NotARoomba/Athena/hardware/athena.kicad_pcb

## KiCad design hardware/athena.kicad_pcb (2026-08-28)

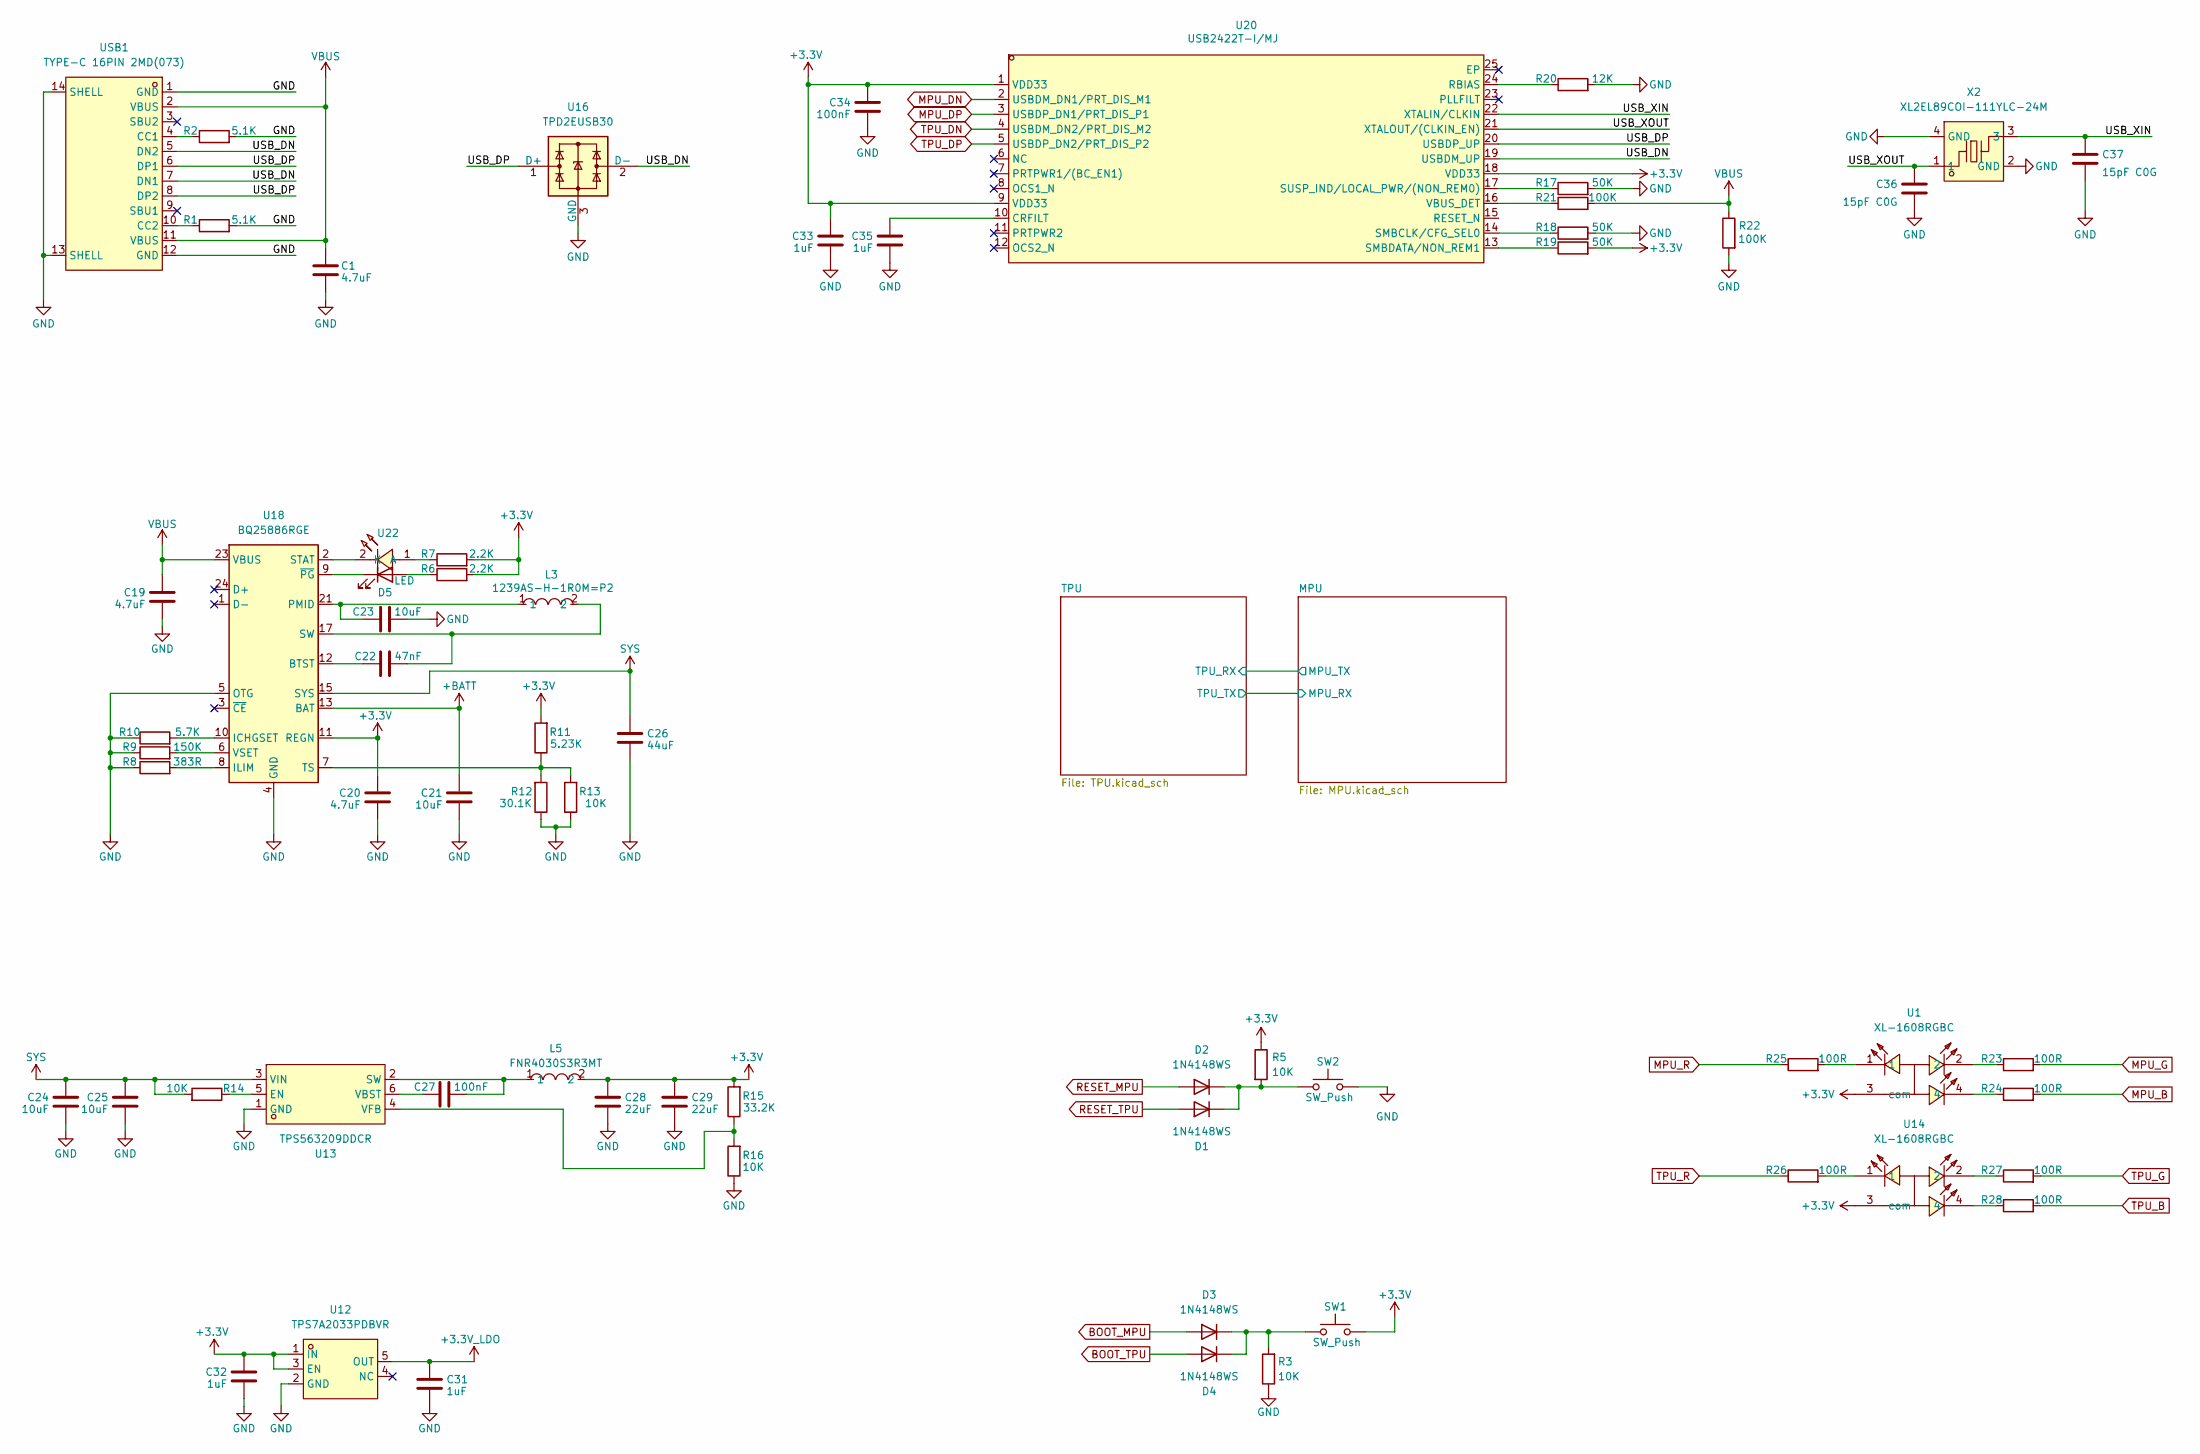
[picture p1: schematic athena.kicad_sch]

Parts:
C1, C19, C20: 4.7uF; C_0603_1608Metric
C21, C23, C24, C25: 10uF; C_0603_1608Metric
C22: 47nF; C_0402_1005Metric
C26: 44uF; C_0805_2012Metric
C27: 100nF; C_0402_1005Metric
C28, C29: 22uF; C_0805_2012Metric
C31, C32, C33, C35: 1uF; C_0402_1005Metric_Pad0.74x0.62mm_HandSolder
C34: 100nF; C_0402_1005Metric_Pad0.74x0.62mm_HandSolder
C36, C37: 15pF C0G; C_0402_1005Metric_Pad0.74x0.62mm_HandSolder
D1, D2, D3, D4: 1N4148WS; D_SOD-323
D5: LED; LED_0402_1005Metric; LCSC C52125197
L3: 1239AS-H-1R0M=P2; L1008; MPN 1239AS-H-1R0M=P2; LCSC Part C167447
L5: FNR4030S3R3MT; IND-SMD_L4.0-W4.0_FNR40XXS; MPN FNR4030S3R3MT; LCSC Part C167870
R1, R2: 5.1K; R_0402_1005Metric
R3, R5, R13, R14, R16: 10K; R_0402_1005Metric
R6, R7: 2.2K; R_0402_1005Metric
R8: 383R; R_0402_1005Metric
R9: 150K; R_0402_1005Metric
R10: 5.7K; R_0402_1005Metric
R11: 5.23K; R_0402_1005Metric
R12: 30.1K; R_0402_1005Metric
R15: 33.2K; R_0402_1005Metric
R17, R18, R19: 50K; R_0402_1005Metric
R20: 12K; R_0402_1005Metric
R21, R22: 100K; R_0402_1005Metric
R23, R24, R25, R26, R27, R28: 100R; R_0402_1005Metric
SW1, SW2: SW_Push; SW-SMD_L3.9-W3.0-P4.45; LCSC C720477
U1, U14: XL-1608RGBC; LED-SMD_4P-L1.6-W0.8-BL; MPN XL-1608RGBC; LCSC Part C5349936
U12: TPS7A2033PDBVR; SOT-23-5_L2.9-W1.6-P0.95-LS2.8-BR; LCSC Part C2862740
U13: TPS563209DDCR; SOT-23-6_L2.9-W1.6-P0.95-LS2.8-BR; LCSC Part C181974
U16: TPD2EUSB30; Texas_DRT-3
U18: BQ25886RGE; Texas_RGE0024H_VQFN-24-1EP_4x4mm_P0.5mm_EP2.7x2.7mm
U20: USB2422T-I/MJ; QFN-24_L4.0-W4.0-P0.50-TL-EP2.5; LCSC Part C622610
U22: SZYY0402Y_C434450; LED0402-FD_YELLOW; LCSC Part C434450
USB1: TYPE-C 16PIN 2MD(073); USB-C-SMD_TYPE-C-6PIN-2MD-073; LCSC Part C2765186
X2: XL2EL89COI-111YLC-24M; CRYSTAL-SMD_4P-L3.2-W2.5-BL; MPN XL2EL89COI-111YLC-24M; LCSC Part C5444545

Connections:
+3.3V: C20.1, C28.1, C29.1, C32.1, C33.1, C34.1, L5.2, R5.1, R6.2, R7.2, R11.2, R15.2, R19.2, SW1.2, U1.3 (com), U12.1 (IN), U12.3 (EN), U14.3 (com), U18.11 (REGN), U20.1 (VDD33), U20.9 (VDD33), U20.18 (VDD33); also elsewhere on the board
+3.3V_LDO: C31.1, U12.5 (OUT); also elsewhere on the board
+BATT: C21.1, U18.13 (BAT), U18.14 (BAT)
/USB_DN: U16.2 (D-), U20.19 (USBDM_UP), USB1.5 (DN2), USB1.7 (DN1)
/USB_DP: U16.1 (D+), U20.20 (USBDP_UP), USB1.6 (DP1), USB1.8 (DP2)
/USB_XIN: C37.1, U20.22 (XTALIN/CLKIN), X2.3
/USB_XOUT: C36.1, U20.21 (XTALOUT/(CLKIN_EN)), X2.1
BOOT_MPU: D3.2 (A); also elsewhere on the board
BOOT_TPU: D4.2 (A); also elsewhere on the board
GND: C1.2, C19.2, C20.2, C21.2, C23.2, C24.2, C25.2, C26.2, C28.2, C29.2, C31.2, C32.2, C33.2, C34.2, C35.2, C36.2, C37.2, R1.2, R2.2, R3.1, R8.1, R9.1, R10.1, R12.1, R13.1, R16.1, R17.2, R18.2, R20.2, R22.2, SW2.2, U12.2 (GND), U13.1 (GND), U16.3 (GND), U18.4 (GND), U18.5 (OTG), U18.19 (GND), U18.20 (GND), U18.25 (GND), USB1.1 (GND), USB1.12 (GND), USB1.13 (SHELL), USB1.14 (SHELL), X2.2 (GND), X2.4 (GND); also elsewhere on the board
MPU_B: R24.2; also elsewhere on the board
MPU_DN: U20.2 (USBDM_DN1/PRT_DIS_M1); also elsewhere on the board
MPU_DP: U20.3 (USBDP_DN1/PRT_DIS_P1); also elsewhere on the board
MPU_G: R23.2; also elsewhere on the board
MPU_R: R25.1; also elsewhere on the board
unnamed: C22.1, L3.2, U18.17 (SW), U18.18 (SW)
unnamed: C23.1, L3.1, U18.21 (PMID), U18.22 (PMID)
unnamed: D1.1 (K), D2.1 (K), R5.2, SW2.1
unnamed: D3.1 (K), D4.1 (K), R3.2, SW1.1
unnamed: D5.2 (A), R6.1
unnamed: D5.1 (K), U18.9 (~PG)
unnamed: R23.1, U1.2
unnamed: R24.1, U1.4
unnamed: R25.2, U1.1
unnamed: R26.2, U14.1
unnamed: R27.1, U14.2
unnamed: R28.1, U14.4
unnamed: R14.1, U13.5 (EN)
unnamed: C27.1, L5.1, U13.2 (SW)
unnamed: C27.2, U13.6 (VBST)
unnamed: R15.1, R16.2, U13.4 (VFB)
unnamed: C22.2, U18.12 (BTST)
unnamed: R10.2, U18.10 (ICHGSET)
unnamed: R8.2, U18.8 (ILIM)
unnamed: U18.2 (STAT), U22.2 (K)
unnamed: R11.1, R12.2, R13.2, U18.7 (TS)
unnamed: R9.2, U18.6 (VSET)
unnamed: C35.1, U20.10 (CRFILT)
unnamed: R20.1, U20.24 (RBIAS)
unnamed: R18.1, U20.14 (SMBCLK/CFG_SEL0)
unnamed: R19.1, U20.13 (SMBDATA/NON_REM1)
unnamed: R17.1, U20.17 (SUSP_IND/LOCAL_PWR/(NON_REM0))
unnamed: R21.1, U20.16 (VBUS_DET)
unnamed: R7.1, U22.1 (A)
unnamed: R2.1, USB1.4 (CC1)
unnamed: R1.1, USB1.10 (CC2)
RESET_MPU: D2.2 (A); also elsewhere on the board
RESET_TPU: D1.2 (A); also elsewhere on the board
SYS: C24.1, C25.1, C26.1, R14.2, U13.3 (VIN), U18.15 (SYS), U18.16 (SYS)
TPU_B: R28.2; also elsewhere on the board
TPU_DN: U20.4 (USBDM_DN2/PRT_DIS_M2); also elsewhere on the board
TPU_DP: U20.5 (USBDP_DN2/PRT_DIS_P2); also elsewhere on the board
TPU_G: R27.2; also elsewhere on the board
TPU_R: R26.1; also elsewhere on the board
VBUS: C1.1, C19.1, R21.2, R22.1, U18.23 (VBUS), USB1.2 (VBUS), USB1.11 (VBUS)

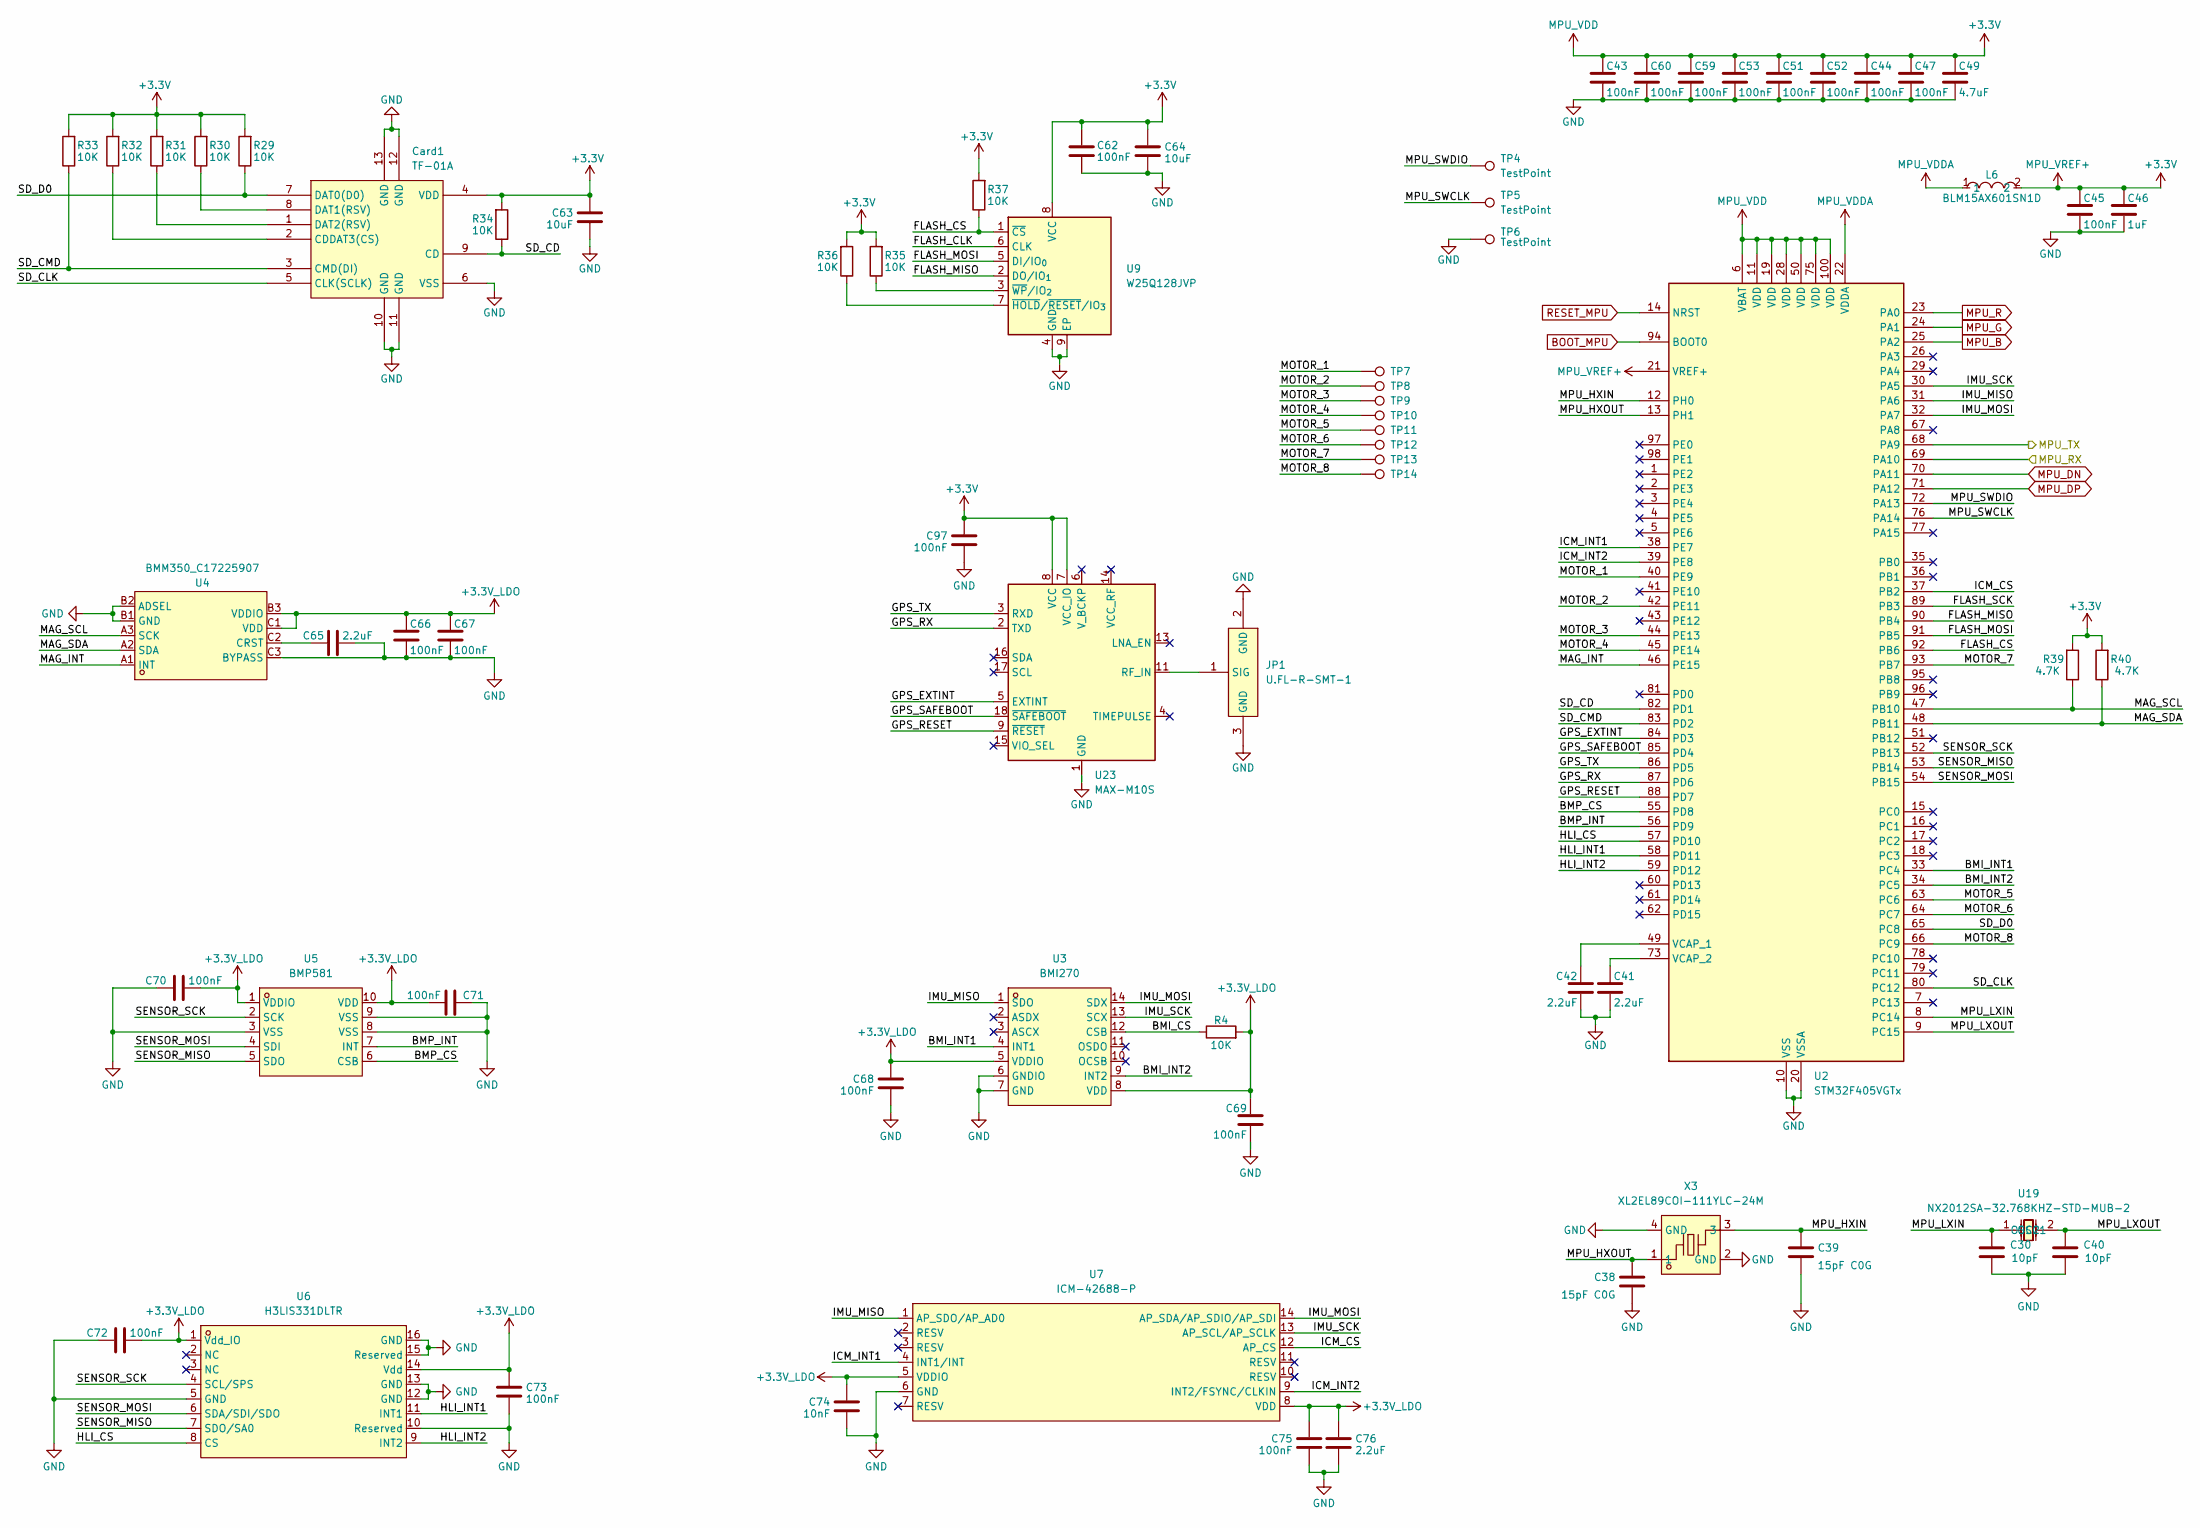
[picture p2: schematic MPU.kicad_sch]

Parts:
C30, C40: 10pF; C_0402_1005Metric
C38, C39: 15pF C0G; C_0402_1005Metric_Pad0.74x0.62mm_HandSolder
C41, C42, C65, C76: 2.2uF; C_0402_1005Metric
C43, C44, C45, C47, C51, C52, C53, C59, C60, C62, C66, C67, C68, C69, C70, C71, C72, C73, C75, C97: 100nF; C_0402_1005Metric
C46: 1uF; C_0402_1005Metric
C49: 4.7uF; C_0603_1608Metric
C63, C64: 10uF; C_0603_1608Metric
C74: 10nF; C_0402_1005Metric
Card1: TF-01A; TF-SMD_TF-01A; LCSC Part C91145
JP1: U.FL-R-SMT-1; RF-SMD_FRF05002-JSS103M; MPN U.FL-R-SMT-1(80); LCSC Part C88374
L6: BLM15AX601SN1D; L0402; MPN BLM15AX601SN1D; LCSC Part C76886
R4, R29, R30, R31, R32, R33, R34, R35, R36, R37: 10K; R_0402_1005Metric
R39, R40: 4.7K; R_0402_1005Metric
TP4, TP5, TP6: TestPoint; TestPoint_Pad_1.0x1.0mm
TP7, TP8, TP9, TP10, TP11, TP12, TP13, TP14: TestPoint; TestPoint_Pill
U2: STM32F405VGTx; LQFP-100_14x14mm_P0.5mm
U3: BMI270; LGA-14_L3.0-W2.5-P0.50-BR; LCSC Part C2836813
U4: BMM350_C17225907; WLCSP-9_L1.3-W1.3-R3-C3-P0.40-TL; LCSC Part C17225907
U5: BMP581; LGA-10_L2.0-W2.0-P0.50-TL_BMP581; LCSC Part C5362283
U6: H3LIS331DLTR; LGA-16_L3.0-W3.0-P0.50-BL; LCSC Part C2655074
U7: ICM-42688-P; LGA-14_L3.0-W2.5-P0.50-TL; LCSC Part C1850418
U9: W25Q128JVP; WSON-8-1EP_6x5mm_P1.27mm_EP3.4x4.3mm
U19: NX2012SA-32.768KHZ-STD-MUB-2; CRYSTAL-SMD_L2.0-W1.2; LCSC Part C891748
U23: MAX-M10S; ublox_MAX
X3: XL2EL89COI-111YLC-24M; CRYSTAL-SMD_4P-L3.2-W2.5-BL; MPN XL2EL89COI-111YLC-24M; LCSC Part C5444545

Connections:
+3.3V: C43.1, C44.1, C45.1, C46.1, C47.1, C49.1, C51.1, C52.1, C53.1, C59.1, C60.1, C62.1, C63.1, C64.1, C97.1, Card1.4 (VDD), L6.2, R29.2, R30.2, R31.2, R32.2, R33.2, R34.2, R35.2, R36.2, R37.2, R39.2, R40.2, U2.6 (VBAT), U2.11 (VDD), U2.19 (VDD), U2.21 (VREF+), U2.28 (VDD), U2.50 (VDD), U2.75 (VDD), U2.100 (VDD), U9.8 (VCC), U23.7 (VCC_IO), U23.8 (VCC); also elsewhere on the board
+3.3V_LDO: C66.1, C67.1, C68.1, C69.1, C70.2, C71.2, C72.2, C73.1, C74.1, C75.1, C76.1, R4.2, U3.5 (VDDIO), U3.8 (VDD), U4.B3 (VDDIO), U4.C1 (VDD), U5.1 (VDDIO), U5.10 (VDD), U6.1 (Vdd_IO), U6.14 (Vdd), U7.5 (VDDIO), U7.8 (VDD); also elsewhere on the board
/MPU/BMI_CS: R4.1, U3.12 (CSB)
/MPU/BMI_INT1: U2.33 (PC4), U3.4 (INT1)
/MPU/BMI_INT2: U2.34 (PC5), U3.9 (INT2)
/MPU/BMP_CS: U2.55 (PD8), U5.6 (CSB)
/MPU/BMP_INT: U2.56 (PD9), U5.7 (INT)
/MPU/FLASH_CLK: U9.6 (CLK)
/MPU/FLASH_CS: R37.1, U2.92 (PB6), U9.1 (~CS)
/MPU/FLASH_MISO: U2.90 (PB4), U9.2 (DO/IO_{1})
/MPU/FLASH_MOSI: U2.91 (PB5), U9.5 (DI/IO_{0})
/MPU/FLASH_SCK: U2.89 (PB3)
/MPU/GPS_EXTINT: U2.84 (PD3), U23.5 (EXTINT)
/MPU/GPS_RESET: U2.88 (PD7), U23.9 (~RESET)
/MPU/GPS_RX: U2.87 (PD6), U23.2 (TXD)
/MPU/GPS_SAFEBOOT: U2.85 (PD4), U23.18 (~SAFEBOOT)
/MPU/GPS_TX: U2.86 (PD5), U23.3 (RXD)
/MPU/HLI_CS: U2.57 (PD10), U6.8 (CS)
/MPU/HLI_INT1: U2.58 (PD11), U6.11 (INT1)
/MPU/HLI_INT2: U2.59 (PD12), U6.9 (INT2)
/MPU/ICM_CS: U2.37 (PB2), U7.12 (AP_CS)
/MPU/ICM_INT1: U2.38 (PE7), U7.4 (INT1/INT)
/MPU/ICM_INT2: U2.39 (PE8), U7.9 (INT2/FSYNC/CLKIN)
/MPU/IMU_MISO: U2.31 (PA6), U3.1 (SDO), U7.1 (AP_SDO/AP_AD0)
/MPU/IMU_MOSI: U2.32 (PA7), U3.14 (SDX), U7.14 (AP_SDA/AP_SDIO/AP_SDI)
/MPU/IMU_SCK: U2.30 (PA5), U3.13 (SCX), U7.13 (AP_SCL/AP_SCLK)
/MPU/MAG_INT: U2.46 (PE15), U4.A1 (INT)
/MPU/MAG_SCL: R39.1, U2.47 (PB10), U4.A3 (SCK)
/MPU/MAG_SDA: R40.1, U2.48 (PB11), U4.A2 (SDA)
/MPU/MOTOR_1: TP7.1 (1_1), U2.40 (PE9)
/MPU/MOTOR_2: TP8.1 (1_1), U2.42 (PE11)
/MPU/MOTOR_3: TP9.1 (1_1), U2.44 (PE13)
/MPU/MOTOR_4: TP10.1 (1_1), U2.45 (PE14)
/MPU/MOTOR_5: TP11.1 (1_1), U2.63 (PC6)
/MPU/MOTOR_6: TP12.1 (1_1), U2.64 (PC7)
/MPU/MOTOR_7: TP13.1 (1_1), U2.93 (PB7)
/MPU/MOTOR_8: TP14.1 (1_1), U2.66 (PC9)
/MPU/MPU_HXIN: C39.1, U2.12 (PH0), X3.3
/MPU/MPU_HXOUT: C38.1, U2.13 (PH1), X3.1
/MPU/MPU_LXIN: C30.1, U2.8 (PC14), U19.1 (OSC1)
/MPU/MPU_LXOUT: C40.1, U2.9 (PC15), U19.2 (OSC2)
/MPU/MPU_RX: U2.69 (PA10); also elsewhere on the board
/MPU/MPU_SWCLK: TP5.1 (1_1), U2.76 (PA14)
/MPU/MPU_SWDIO: TP4.1 (1_1), U2.72 (PA13)
/MPU/MPU_TX: U2.68 (PA9); also elsewhere on the board
/MPU/SD_CD: Card1.9 (CD), R34.1, U2.82 (PD1)
/MPU/SD_CLK: Card1.5 (CLK(SCLK)), U2.80 (PC12)
/MPU/SD_CMD: Card1.3 (CMD(DI)), R33.1, U2.83 (PD2)
/MPU/SD_D0: Card1.7 (DAT0(D0)), R29.1, U2.65 (PC8)
/MPU/SENSOR_MISO: U2.53 (PB14), U5.5 (SDO), U6.7 (SDO/SA0)
/MPU/SENSOR_MOSI: U2.54 (PB15), U5.4 (SDI), U6.6 (SDA/SDI/SDO)
/MPU/SENSOR_SCK: U2.52 (PB13), U5.2 (SCK), U6.4 (SCL/SPS)
BOOT_MPU: U2.94 (BOOT0); also elsewhere on the board
GND: C30.2, C38.2, C39.2, C40.2, C41.2, C42.2, C43.2, C44.2, C45.2, C46.2, C47.2, C49.2, C51.2, C52.2, C53.2, C59.2, C60.2, C62.2, C63.2, C64.2, C65.1, C66.2, C67.2, C68.2, C69.2, C70.1, C71.1, C72.1, C73.2, C74.2, C75.2, C76.2, C97.2, Card1.6 (VSS), Card1.10 (GND), Card1.11 (GND), Card1.12 (GND), Card1.13 (GND), JP1.2 (GND), JP1.3 (GND), TP6.1 (1_1), U2.10 (VSS), U2.20 (VSSA), U2.27 (VSS), U2.74 (VSS), U2.99 (VSS), U3.6 (GNDIO), U3.7 (GND), U4.B1 (GND), U4.B2 (ADSEL), U4.C3 (BYPASS), U5.3 (VSS), U5.8 (VSS), U5.9 (VSS), U6.5 (GND), U6.10 (Reserved), U6.12 (GND), U6.13 (GND), U6.15 (Reserved), U6.16 (GND), U7.6 (GND), U9.4 (GND), U9.9 (EP), U23.1 (GND), U23.10 (GND), U23.12 (GND), X3.2 (GND), X3.4 (GND); also elsewhere on the board
MPU_B: U2.25 (PA2); also elsewhere on the board
MPU_DN: U2.70 (PA11); also elsewhere on the board
MPU_DP: U2.71 (PA12); also elsewhere on the board
MPU_G: U2.24 (PA1); also elsewhere on the board
MPU_R: U2.23 (PA0); also elsewhere on the board
MPU_VDDA: L6.1, U2.22 (VDDA)
unnamed: Card1.2 (CDDAT3(CS)), R32.1
unnamed: Card1.8 (DAT1(RSV)), R30.1
unnamed: Card1.1 (DAT2(RSV)), R31.1
unnamed: JP1.1 (SIG), U23.11 (RF_IN)
unnamed: C42.1, U2.49 (VCAP_1)
unnamed: C41.1, U2.73 (VCAP_2)
unnamed: C65.2, U4.C2 (CRST)
unnamed: R36.1, U9.7 (~HOLD/~RESET/IO_{3})
unnamed: R35.1, U9.3 (~WP/IO_{2})
RESET_MPU: U2.14 (NRST); also elsewhere on the board

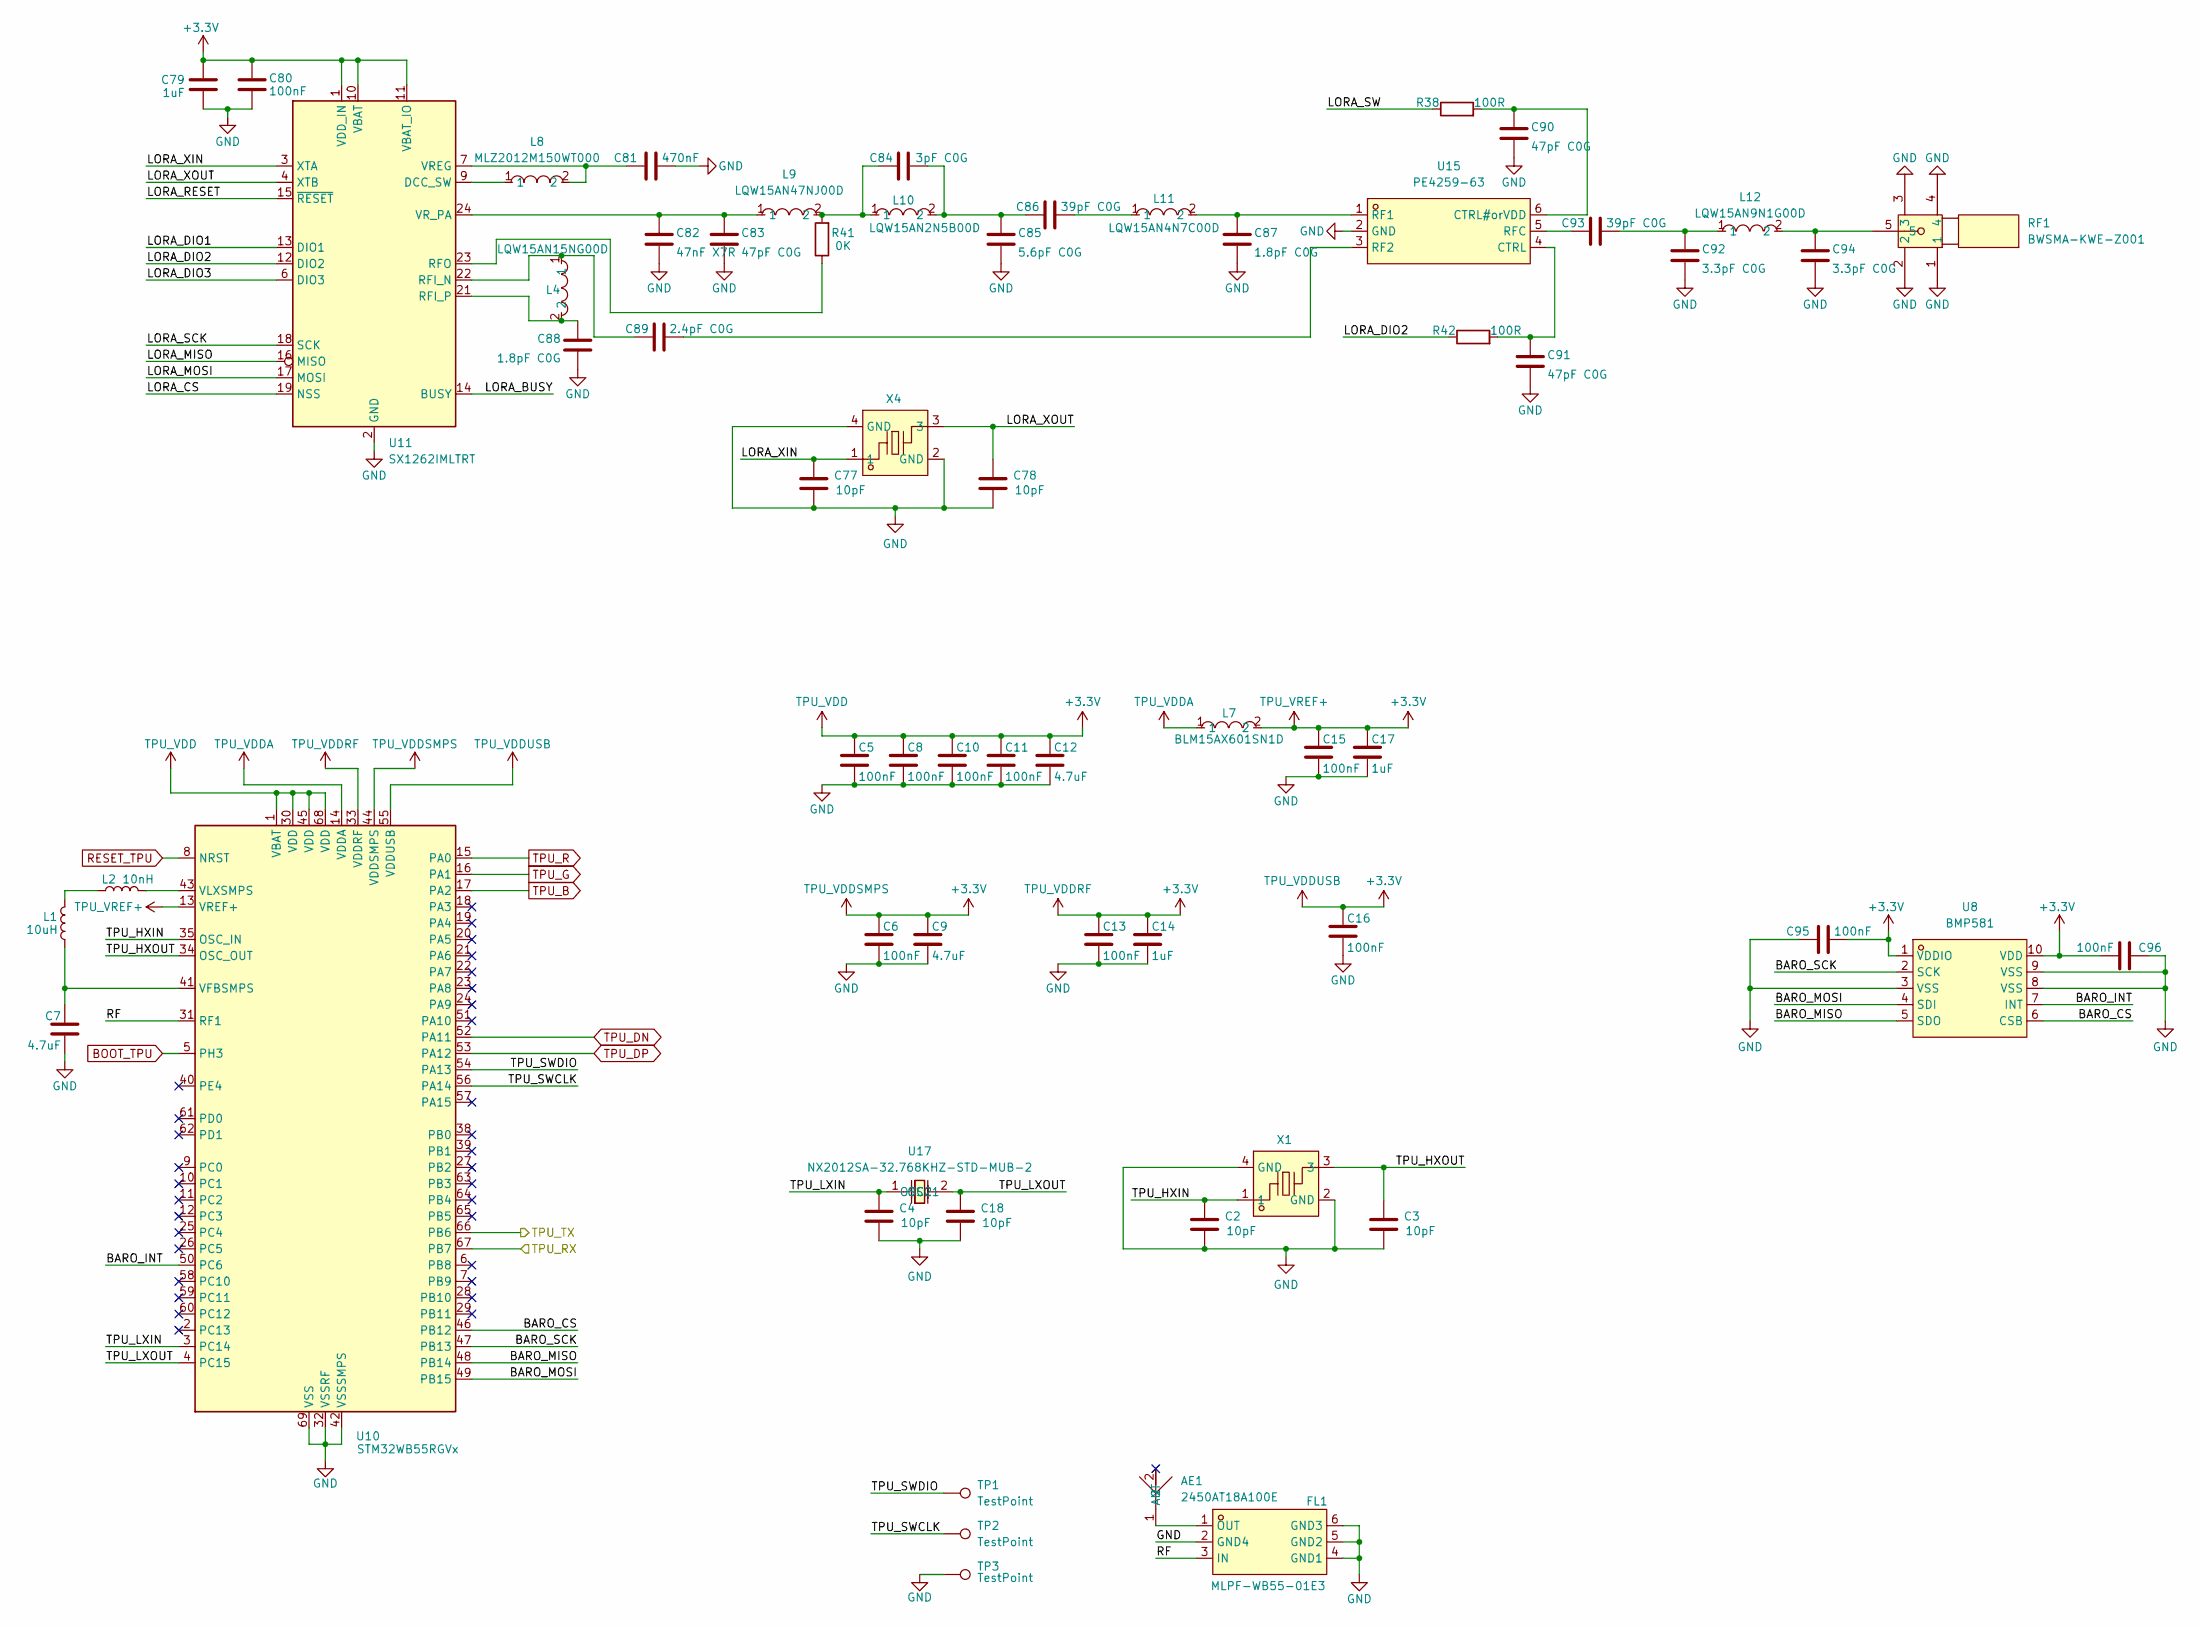
[picture p3: schematic TPU.kicad_sch]

Parts:
AE1: 2450AT18A100E; ANT-SMD_L3.2-W1.6; LCSC Part C89334
C2, C3, C4, C18, C77, C78: 10pF; C_0402_1005Metric
C5, C6, C8, C10, C11, C13, C15, C16, C80, C95, C96: 100nF; C_0402_1005Metric
C7, C9, C12: 4.7uF; C_0603_1608Metric
C14, C17: 1uF; C_0402_1005Metric
C79: 1uF; C_0402_1005Metric_Pad0.74x0.62mm_HandSolder
C81: 470nF; C_0402_1005Metric
C82: 47nF X7R; C_0402_1005Metric
C83, C90, C91: 47pF C0G; C_0402_1005Metric
C84: 3pF C0G; C_0402_1005Metric
C85: 5.6pF C0G; C_0402_1005Metric
C86, C93: 39pF C0G; C_0402_1005Metric
C87, C88: 1.8pF C0G; C_0402_1005Metric
C89: 2.4pF C0G; C_0402_1005Metric
C92, C94: 3.3pF C0G; C_0402_1005Metric
FL1: MLPF-WB55-01E3; FILTER-SMD_6P-L1.6-W1.0-P0.50-BL; LCSC Part C2651048
L1: 10uH; L_0603_1608Metric
L2: 10nH; L_0603_1608Metric
L4: LQW15AN15NG00D; IND-SMD_L1.0-W0.5-2; MPN LQW15AN15NG00D; LCSC Part C98055
L7: BLM15AX601SN1D; L0402; MPN BLM15AX601SN1D; LCSC Part C76886
L8: MLZ2012M150WT000; L0805; MPN MLZ2012M150WT000; LCSC Part C383402
L9: LQW15AN47NJ00D; L0402; MPN LQW15AN47NJ00D; LCSC Part C192855
L10: LQW15AN2N5B00D; L0402; MPN LQW15AN2N5B00D; LCSC Part C237342
L11: LQW15AN4N7C00D; L0402; MPN LQW15AN4N7C00D; LCSC Part C167480
L12: LQW15AN9N1G00D; L0402; MPN LQW15AN9N1G00D; LCSC Part C113122
R38, R42: 100R; R_0402_1005Metric
R41: 0K; R_0402_1005Metric
RF1: BWSMA-KWE-Z001; SMA-TH_BWSMA-KWE-Z001; LCSC Part C496551
TP1, TP2, TP3: TestPoint; TestPoint_Pad_1.0x1.0mm
U8: BMP581; LGA-10_L2.0-W2.0-P0.50-TL_BMP581; LCSC Part C5362283
U10: STM32WB55RGVx; QFN-68-1EP_8x8mm_P0.4mm_EP6.4x6.4mm; LCSC C401505
U11: SX1262IMLTRT; QFN-24-1EP_4x4mm_P0.5mm_EP2.6x2.6mm
U15: PE4259-63; SC-70-6_L2.2-W1.3-P0.65-LS2.1-BL; MPN PE4259-63; LCSC Part C470892
U17: NX2012SA-32.768KHZ-STD-MUB-2; CRYSTAL-SMD_L2.0-W1.2; LCSC Part C891748
X1, X4: NX2016SA-32MHZ-STD-CZS-5; OSC-SMD_4P-L2.0-W1.6-BL; LCSC Part C843260

Connections:
+3.3V: C5.1, C6.1, C8.1, C9.1, C10.1, C11.1, C12.1, C13.1, C14.1, C15.1, C16.1, C17.1, C79.1, C80.1, C95.2, C96.2, L7.2, U8.1 (VDDIO), U8.10 (VDD), U10.1 (VBAT), U10.13 (VREF+), U10.30 (VDD), U10.33 (VDDRF), U10.44 (VDDSMPS), U10.45 (VDD), U10.55 (VDDUSB), U10.68 (VDD), U11.1 (VDD_IN), U11.10 (VBAT), U11.11 (VBAT_IO); also elsewhere on the board
/MPU/MPU_RX: U10.66 (PB6); also elsewhere on the board
/MPU/MPU_TX: U10.67 (PB7); also elsewhere on the board
/TPU/BARO_CS: U8.6 (CSB), U10.46 (PB12)
/TPU/BARO_INT: U8.7 (INT), U10.50 (PC6)
/TPU/BARO_MISO: U8.5 (SDO), U10.48 (PB14)
/TPU/BARO_MOSI: U8.4 (SDI), U10.49 (PB15)
/TPU/BARO_SCK: U8.2 (SCK), U10.47 (PB13)
/TPU/LORA_BUSY: U11.14 (BUSY)
/TPU/LORA_CS: U11.19 (NSS)
/TPU/LORA_DIO1: U11.13 (DIO1)
/TPU/LORA_DIO2: R42.1, U11.12 (DIO2)
/TPU/LORA_DIO3: U11.6 (DIO3)
/TPU/LORA_MISO: U11.16 (MISO)
/TPU/LORA_MOSI: U11.17 (MOSI)
/TPU/LORA_RESET: U11.15 (~RESET)
/TPU/LORA_SCK: U11.18 (SCK)
/TPU/LORA_SW: R38.1
/TPU/LORA_XIN: C77.1, U11.3 (XTA), X4.1
/TPU/LORA_XOUT: C78.1, U11.4 (XTB), X4.3
/TPU/RF: FL1.3 (IN), U10.31 (RF1)
/TPU/TPU_HXIN: C2.1, U10.35 (OSC_IN), X1.1
/TPU/TPU_HXOUT: C3.1, U10.34 (OSC_OUT), X1.3
/TPU/TPU_LXIN: C4.1, U10.3 (PC14), U17.1 (OSC1)
/TPU/TPU_LXOUT: C18.1, U10.4 (PC15), U17.2 (OSC2)
/TPU/TPU_SWCLK: TP2.1 (1_1), U10.56 (PA14)
/TPU/TPU_SWDIO: TP1.1 (1_1), U10.54 (PA13)
BOOT_TPU: U10.5 (PH3); also elsewhere on the board
GND: C2.2, C3.2, C4.2, C5.2, C6.2, C7.2, C8.2, C9.2, C10.2, C11.2, C12.2, C13.2, C14.2, C15.2, C16.2, C17.2, C18.2, C77.2, C78.2, C79.2, C80.2, C81.2, C82.2, C83.2, C85.2, C87.2, C88.2, C90.2, C91.2, C92.2, C94.2, C95.1, C96.1, FL1.2 (GND4), FL1.4 (GND1), FL1.5 (GND2), FL1.6 (GND3), RF1.1, RF1.2, RF1.3, RF1.4, TP3.1 (1_1), U8.3 (VSS), U8.8 (VSS), U8.9 (VSS), U10.32 (VSSRF), U10.42 (VSSSMPS), U10.69 (VSS), U11.2 (GND), U11.5 (GND), U11.8 (GND), U11.20 (GND), U11.25 (GND), U15.2 (GND), X1.2 (GND), X1.4 (GND), X4.2 (GND), X4.4 (GND); also elsewhere on the board
unnamed: AE1.1 (ANT_1), FL1.1 (OUT)
unnamed: C84.1, L9.2, L10.1, R41.2
unnamed: C84.2, C85.1, C86.1, L10.2
unnamed: C86.2, L11.1
unnamed: C92.1, C93.2, L12.1
unnamed: C94.1, L12.2, RF1.5
unnamed: L1.1, L2.2
unnamed: C7.1, L1.2, U10.41 (VFBSMPS)
unnamed: L2.1, U10.43 (VLXSMPS)
unnamed: L8.1, U11.9 (DCC_SW)
unnamed: C89.1, L4.1, U11.22 (RFI_N)
unnamed: C88.1, L4.2, U11.21 (RFI_P)
unnamed: R41.1, U11.23 (RFO)
unnamed: C81.1, L8.2, U11.7 (VREG)
unnamed: C82.1, C83.1, L9.1, U11.24 (VR_PA)
unnamed: C90.1, R38.2, U15.6 (CTRL#orVDD)
unnamed: C91.1, R42.2, U15.4 (CTRL)
unnamed: C87.1, L11.2, U15.1 (RF1)
unnamed: C89.2, U15.3 (RF2)
unnamed: C93.1, U15.5 (RFC)
RESET_TPU: U10.8 (NRST); also elsewhere on the board
TPU_B: U10.17 (PA2); also elsewhere on the board
TPU_DN: U10.52 (PA11); also elsewhere on the board
TPU_DP: U10.53 (PA12); also elsewhere on the board
TPU_G: U10.16 (PA1); also elsewhere on the board
TPU_R: U10.15 (PA0); also elsewhere on the board
TPU_VDDA: L7.1, U10.14 (VDDA)

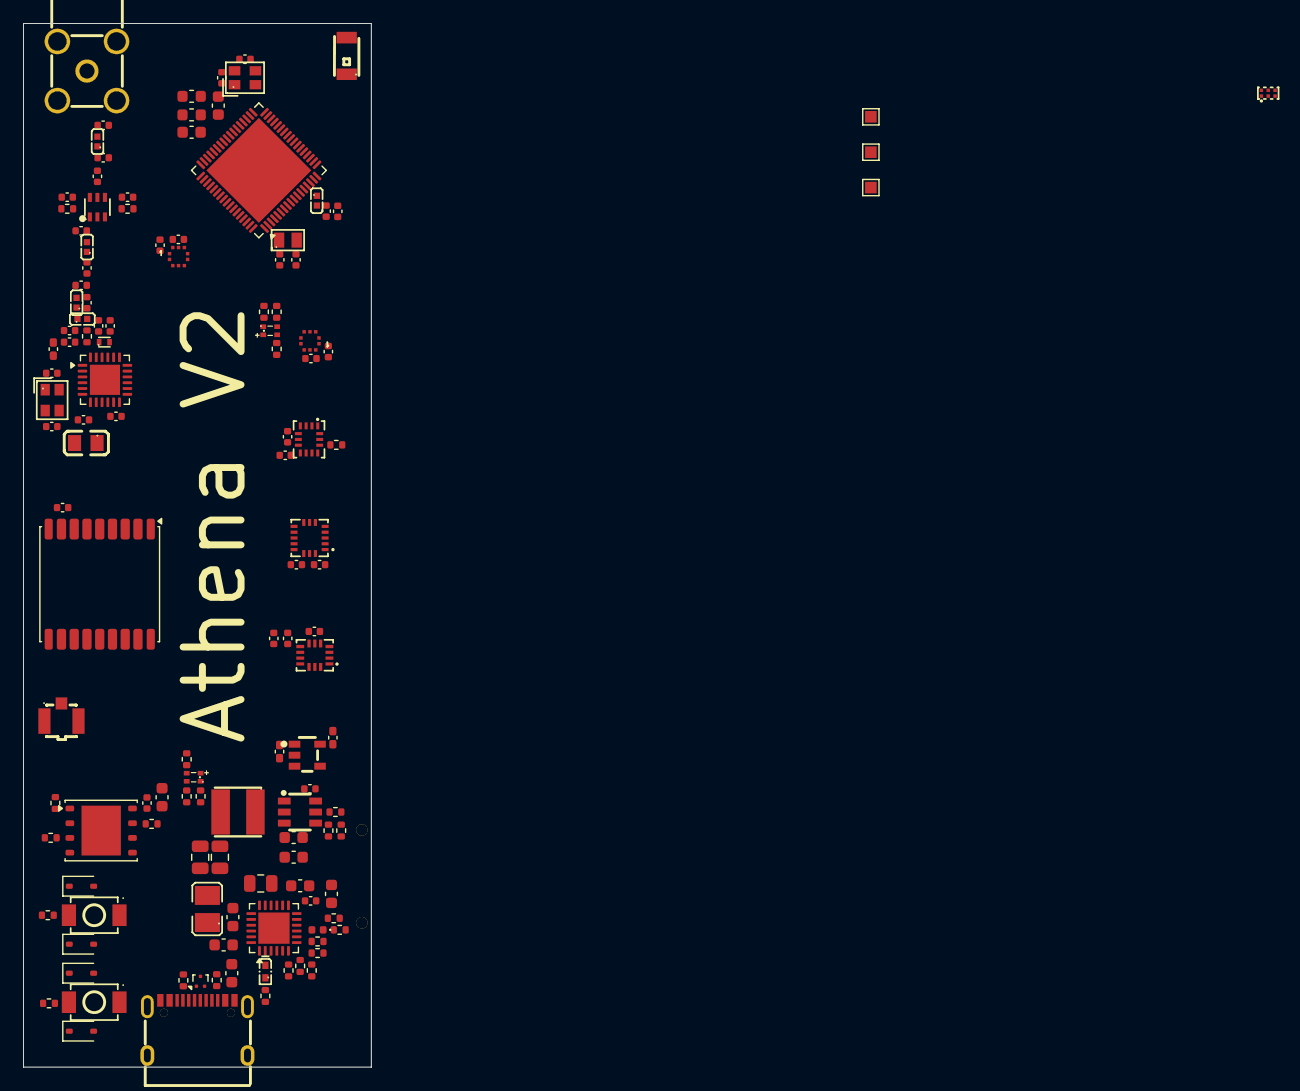
[picture p4: board athena.kicad_pcb from above]

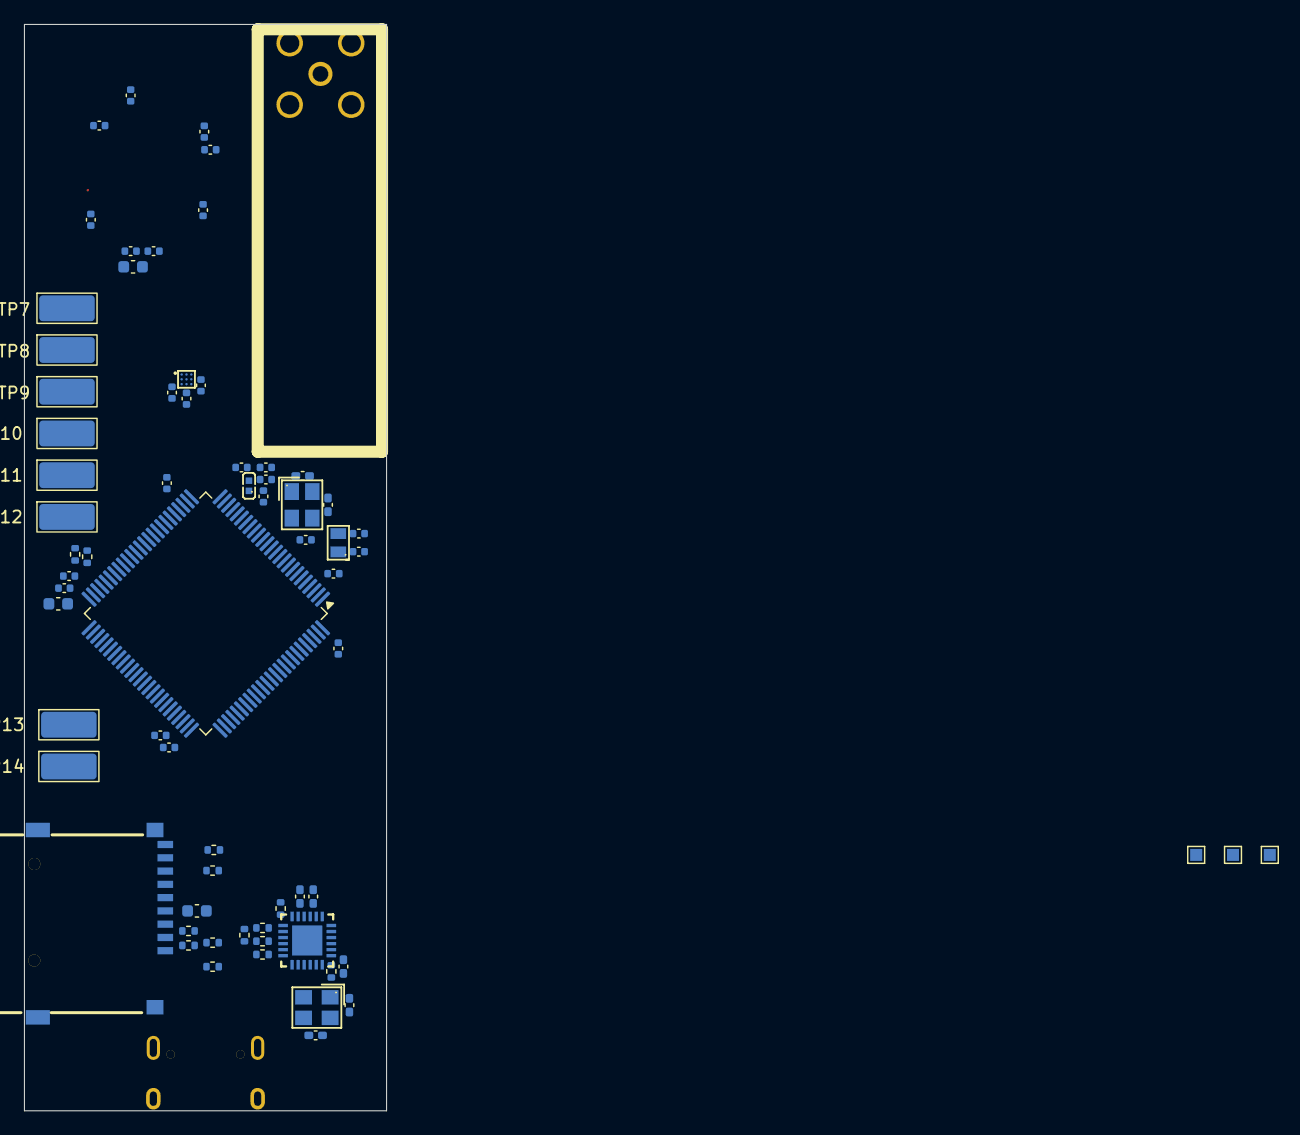
[picture p5: board athena.kicad_pcb from below]

Board: 4 copper layers, 30.0 x 90.0 mm, 196 parts (68 on the bottom side), 149 nets.
