NotARoomba/Athena/firmware/MPU/MPU.ioc

Mcu.UserName=STM32F405VGTx
PA0-WKUP.GPIO_Label=MPU_R
PA0-WKUP.Signal=S_TIM2_CH1_ETR
PA1.GPIO_Label=MPU_G
PA1.Signal=S_TIM2_CH2
PA10.GPIO_Label=TPU_RX
PA10.Signal=USART1_RX
PA11.Signal=USB_OTG_FS_DM
PA12.Signal=USB_OTG_FS_DP
PA13.Signal=SYS_JTMS-SWDIO
PA14.Signal=SYS_JTCK-SWCLK
PA2.GPIO_Label=MPU_B
PA2.Signal=S_TIM2_CH3
PA5.GPIO_Label=IMU_SCK
PA5.Signal=SPI1_SCK
PA6.GPIO_Label=IMU_MISO
PA6.Signal=SPI1_MISO
PA7.GPIO_Label=IMU_MOSI
PA7.Signal=SPI1_MOSI
PA9.GPIO_Label=TPU_TX
PA9.Signal=USART1_TX
PB1.GPIO_Label=MOTOR_7
PB1.Signal=TIM8_CH3N
PB10.GPIO_Label=MAG_SCL
PB10.Signal=I2C2_SCL
PB11.GPIO_Label=MAG_SDA
PB11.Signal=I2C2_SDA
PB13.GPIO_Label=SENSOR_SCK
PB13.Signal=SPI2_SCK
PB14.GPIO_Label=SENSOR_MISO
PB14.Signal=SPI2_MISO
PB15.GPIO_Label=SENSOR_MOSI
PB15.Signal=SPI2_MOSI
PB2.GPIO_Label=IMU_CS
PB2.Signal=GPIO_Output
PB3.GPIO_Label=FLASH_SCK
PB3.Signal=SPI3_SCK
PB4.GPIO_Label=FLASH_MISO
PB4.Signal=SPI3_MISO
PB5.GPIO_Label=FLASH_MOSI
PB5.Signal=SPI3_MOSI
PB6.GPIO_Label=FLASH_CS
PB6.Signal=GPIO_Output
PC12.Signal=SDIO_CK
PC14-OSC32_IN.Signal=RCC_OSC32_IN
PC15-OSC32_OUT.Signal=RCC_OSC32_OUT
PC4.GPIO_Label=BMI_INT1
PC4.Signal=GPXTI4
PC5.GPIO_Label=BMI_INT2
PC5.Signal=GPXTI5
PC6.GPIO_Label=MOTOR_5
PC6.Signal=S_TIM8_CH1
PC7.GPIO_Label=MOTOR_6
PC7.Signal=S_TIM8_CH2
PC8.Signal=SDIO_D0
PC9.GPIO_Label=MOTOR_8
PC9.Signal=S_TIM8_CH4
PD1.GPIO_Label=SD_CD
PD1.Signal=GPIO_Input
PD10.GPIO_Label=HLI_CS
PD10.Signal=GPIO_Output
PD11.GPIO_Label=HLI_INT1
PD11.Signal=GPXTI11
PD12.GPIO_Label=HLI_INT2
PD12.Signal=GPXTI12
PD2.Signal=SDIO_CMD
PD3.GPIO_Label=GPS_EXTINT
PD3.Signal=EVENTOUT
PD4.GPIO_Label=GPS_SAFEBOOT
PD4.Signal=GPIO_Output
PD5.GPIO_Label=GPS_TX
PD5.Signal=USART2_TX
PD6.GPIO_Label=GPS_RX
PD6.Signal=USART2_RX
PD7.GPIO_Label=GPS_RESET
PD7.Signal=GPIO_Output
PD8.GPIO_Label=BMP_CS
PD8.Signal=GPIO_Output
PD9.GPIO_Label=BMP_INT
PD9.Signal=GPXTI9
PE11.GPIO_Label=MOTOR_2
PE11.Signal=S_TIM1_CH2
PE13.GPIO_Label=MOTOR_3
PE13.Signal=S_TIM1_CH3
PE14.GPIO_Label=MOTOR_4
PE14.Signal=S_TIM1_CH4
PE15.GPIO_Label=MAG_INT
PE15.Signal=GPXTI15
PE7.GPIO_Label=IMU_INT1
PE7.Signal=GPXTI7
PE8.GPIO_Label=IMU_INT2
PE8.Signal=GPXTI8
PE9.GPIO_Label=MOTOR_1
PE9.Signal=S_TIM1_CH1
PH0-OSC_IN.Signal=RCC_OSC_IN
PH1-OSC_OUT.Signal=RCC_OSC_OUT
