NotARoomba/Athena/(commit log)

2025-09-20 Revise power management voltage range in README
2025-11-11 physcial pcb
2025-12-03 start imu
2025-12-03 imu stuff
2025-12-03 imu working
2026-03-09 start of v2
    [Athena.eprj, Athena.epro, athena.kicad_pcb, athena.kicad_sch]
2026-06-21 half of schematic
    [athena.kicad_pcb, athena.kicad_sch]
2026-08-28 more stuffx
    [MPU.kicad_sch, TPU.kicad_sch, athena.kicad_pcb, athena.kicad_sch]
